ChristianLovetere/Project-Watchdog/Documentation/ProjectWatchdogSchematicJuly30.pdf

## Stepper Motors + RPi HAT

## RPi, ESP8266, Peripherals

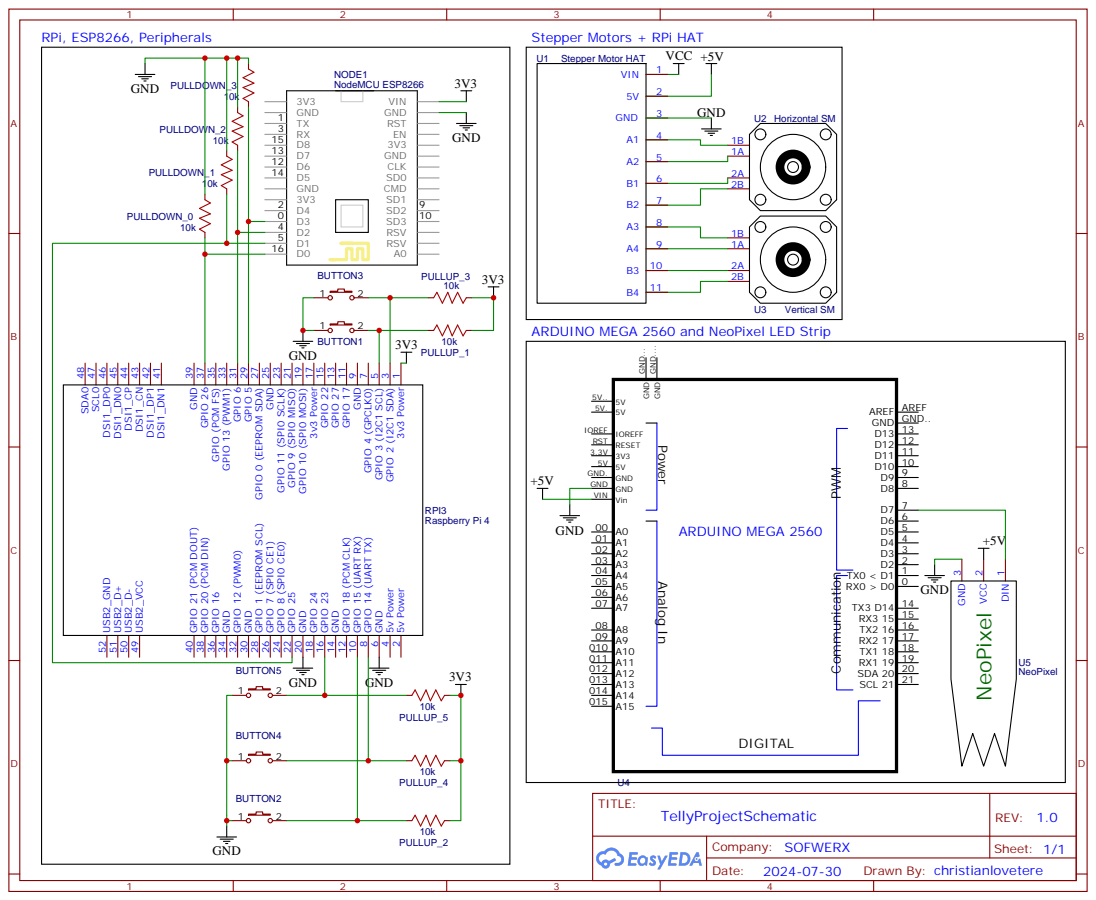
[picture p8: page 1]

ARDUINO MEGA 2560 and NeoPixel LED Strip

9 GPIO 15 (UART RX) 10 GPIO 17 11 GPIO 18 (PCM CLK) 12 GPIO 27 13 GND 14 GPIO 22 15 GPIO 23 16 3v3 Power 17 GPIO 24 18 GPIO 10 (SPI0 MOSI) 19 GND 20 GPIO 9 (SPI0 MISO) 21 GPIO 25 22 GPIO 11 (SPI0 SCLK) 23 GPIO 8 (SPI0 CE0) 24 GND 25 GPIO 7 (SPI0 CE1) 26 GPIO 0 (EEPROM SDA) 27 GPIO 1 (EEPROM SCL) 28 GPIO 5 29 GND 30 GPIO 6 31 GPIO 12 (PWM0) 32 GPIO 13 (PWM1) 33 GND 34 GPIO (PCM FS) 35 GPIO 16 36 GPIO 26 37 GPIO 20 (PCM DIN) 38 GND 39 GPIO 21 (PCM DOUT) 40
