ChristianLovetere/Project-Watchdog/Code/4buttons_via_wifi/4buttons_via_wifi.ino

/*********
  Rui Santos
  Complete project details at http://randomnerdtutorials.com  
*********/

// Load Wi-Fi library
#include <ESP8266WiFi.h>

// Replace with your network credentials
const char* ssid     = "Wifi Server Name";
const char* password = "Wifi Server Password";

// Set web server port number to 80
WiFiServer server(80);

// Variable to store the HTTP request
String header;

// Auxiliar variables to store the current output state
String output2State = "off";
String output0State = "off";
String output1State = "off";
String output3State = "off";

// Assign output variables to GPIO pins
const int output2 = 2;
const int output0 = 0;
const int output1 = 1;
const int output3 = 3;

// Current time
unsigned long currentTime = millis();
// Previous time
unsigned long previousTime = 0; 
// Define timeout time in milliseconds (example: 2000ms = 2s)
const long timeoutTime = 2000;

void setup() {
  Serial.begin(115200);
  // Initialize the output variables as outputs
  pinMode(D2, OUTPUT);
  pinMode(D0, OUTPUT);
  pinMode(D1, OUTPUT);
  pinMode(D3, OUTPUT);
  
  // Set outputs to LOW
  digitalWrite(D2, LOW);
  digitalWrite(D0, LOW);
  digitalWrite(D1, LOW);
  digitalWrite(D3, LOW);

  // Connect to Wi-Fi network with SSID and password
  Serial.print("Connecting to ");
  Serial.println(ssid);
  WiFi.begin(ssid, password);
  while (WiFi.status() != WL_CONNECTED) {
    delay(500);
    Serial.print(".");
  }
  // Print local IP address and start web server
  Serial.println("");
  Serial.println("WiFi connected.");
  Serial.println("IP address: ");
  Serial.println(WiFi.localIP());
  server.begin();
}

void loop(){
  WiFiClient client = server.available();   // Listen for incoming clients

  if (client) {                             // If a new client connects,
    Serial.println("New Client.");          // print a message out in the serial port
    String currentLine = "";                // make a String to hold incoming data from the client
    currentTime = millis();
    previousTime = currentTime;
    while (client.connected() && currentTime - previousTime <= timeoutTime) { // loop while the client's connected
      currentTime = millis();         
      if (client.available()) {             // if there's bytes to read from the client,
        char c = client.read();             // read a byte, then
        Serial.write(c);                    // print it out the serial monitor
        header += c;
        if (c == '\n') {                    // if the byte is a newline character
          // if the current line is blank, you got two newline characters in a row.
          // that's the end of the client HTTP request, so send a response:
          if (currentLine.length() == 0) {
            // HTTP headers always start with a response code (e.g. HTTP/1.1 200 OK)
            // and a content-type so the client knows what's coming, then a blank line:
            client.println("HTTP/1.1 200 OK");
            client.println("Content-type:text/html");
            client.println("Connection: close");
            client.println();
            
            // turns the GPIOs on and off
            if (header.indexOf("GET /2/on") >= 0) {
              Serial.println("GPIO 2 on");
              output2State = "on";
              digitalWrite(D2, HIGH);
            } else if (header.indexOf("GET /2/off") >= 0) {
              Serial.println("GPIO 2 off");
              output2State = "off";
              digitalWrite(D2, LOW);
            } else if (header.indexOf("GET /0/on") >= 0) {
              Serial.println("GPIO 0 on");
              output0State = "on";
              digitalWrite(D0, HIGH);
            } else if (header.indexOf("GET /0/off") >= 0) {
              Serial.println("GPIO 0 off");
              output0State = "off";
              digitalWrite(D0, LOW);
            } else if (header.indexOf("GET /1/on") >= 0) {
              Serial.println("GPIO 1 on");
              output1State = "on";
              digitalWrite(D1, HIGH);
            } else if (header.indexOf("GET /1/off") >= 0) {
              Serial.println("GPIO 1 off");
              output1State = "off";
              digitalWrite(D1, LOW);
            } else if (header.indexOf("GET /3/on") >= 0) {
              Serial.println("GPIO 3 on");
              output3State = "on";
              digitalWrite(D3, HIGH);
            } else if (header.indexOf("GET /3/off") >= 0) {
              Serial.println("GPIO 3 off");
              output3State = "off";
              digitalWrite(D3, LOW);
            } 
            
            // Display the HTML web page
            client.println("<!DOCTYPE html><html>");
            client.println("<head><meta name=\"viewport\" content=\"width=device-width, initial-scale=1\">");
            client.println("<link rel=\"icon\" href=\"data:,\">");
            // CSS to style the on/off buttons 
            // Feel free to change the background-color and font-size attributes to fit your preferences
            client.println("<style>html { font-family: Helvetica; display: inline-block; margin: 0px auto; text-align: center;}");
            client.println(".button { background-color: #195B6A; border: none; color: white; padding: 16px 40px;");
            client.println("text-decoration: none; font-size: 30px; margin: 2px; cursor: pointer;}");
            client.println(".button2 {background-color: #77878A;}</style></head>");
            
            // Web Page Heading
            client.println("<body><h1>ESP8266 Web Server</h1>");
            
            // Display current state, and ON/OFF buttons for GPIO 2  
            client.println("<p>GPIO 2 - UP " + output2State + "</p>");
            // If the output2State is off, it displays the ON button       
            if (output2State=="off") {
              client.println("<p><a href=\"/2/on\"><button class=\"button\">ON</button></a></p>");
            } else {
              client.println("<p><a href=\"/2/off\"><button class=\"button button2\">OFF</button></a></p>");
            } 
   
            // Display current state, and ON/OFF buttons for GPIO 0  
            client.println("<p>GPIO 0 - LEFT " + output0State + " | GPIO 1 - RIGHT " + output1State + "</p>");
            client.println("<div style='display: flex; justify-content: center;'>");
            // If the output0State is off, it displays the ON button       
            if (output0State=="off") {
              client.println("<a href=\"/0/on\"><button class=\"button\">ON</button></a>");
            } else {
              client.println("<a href=\"/0/off\"><button class=\"button button2\">OFF</button></a>");
            }

            // Display current state, and ON/OFF buttons for GPIO 1  
            //client.println("<p>GPIO 1 - RIGHT " + output1State + "</p>");
            // If the output1State is off, it displays the ON button       
            if (output1State=="off") {
              client.println("<a href=\"/1/on\"><button class=\"button\">ON</button></a>");
            } else {
              client.println("<a href=\"/1/off\"><button class=\"button button2\">OFF</button></a>");
            }
            client.println("</div>");

            // Display current state, and ON/OFF buttons for GPIO 3  
            client.println("<p>GPIO 3 - DOWN " + output3State + "</p>");
            // If the output3State is off, it displays the ON button       
            if (output3State=="off") {
              client.println("<a href=\"/3/on\"><button class=\"button\">ON</button></a></p>");
            } else {
              client.println("<a href=\"/3/off\"><button class=\"button button2\">OFF</button></a></p>");
            }
            
            client.println("</body></html>");
            
            // The HTTP response ends with another blank line
            client.println();
            // Break out of the while loop
            break;
          } else { // if you got a newline, then clear currentLine
            currentLine = "";
          }
        } else if (c != '\r') {  // if you got anything else but a carriage return character,
          currentLine += c;      // add it to the end of the currentLine
        }
      }
    }
    // Clear the header variable
    header = "";
    // Close the connection
    client.stop();
    Serial.println("Client disconnected.");
    Serial.println("");
  }
}
